pkwasniok/ki-smart-relay/hardware/hardware.kicad_pcb

## KiCad design hardware/hardware.kicad_pcb (2025-05-27)

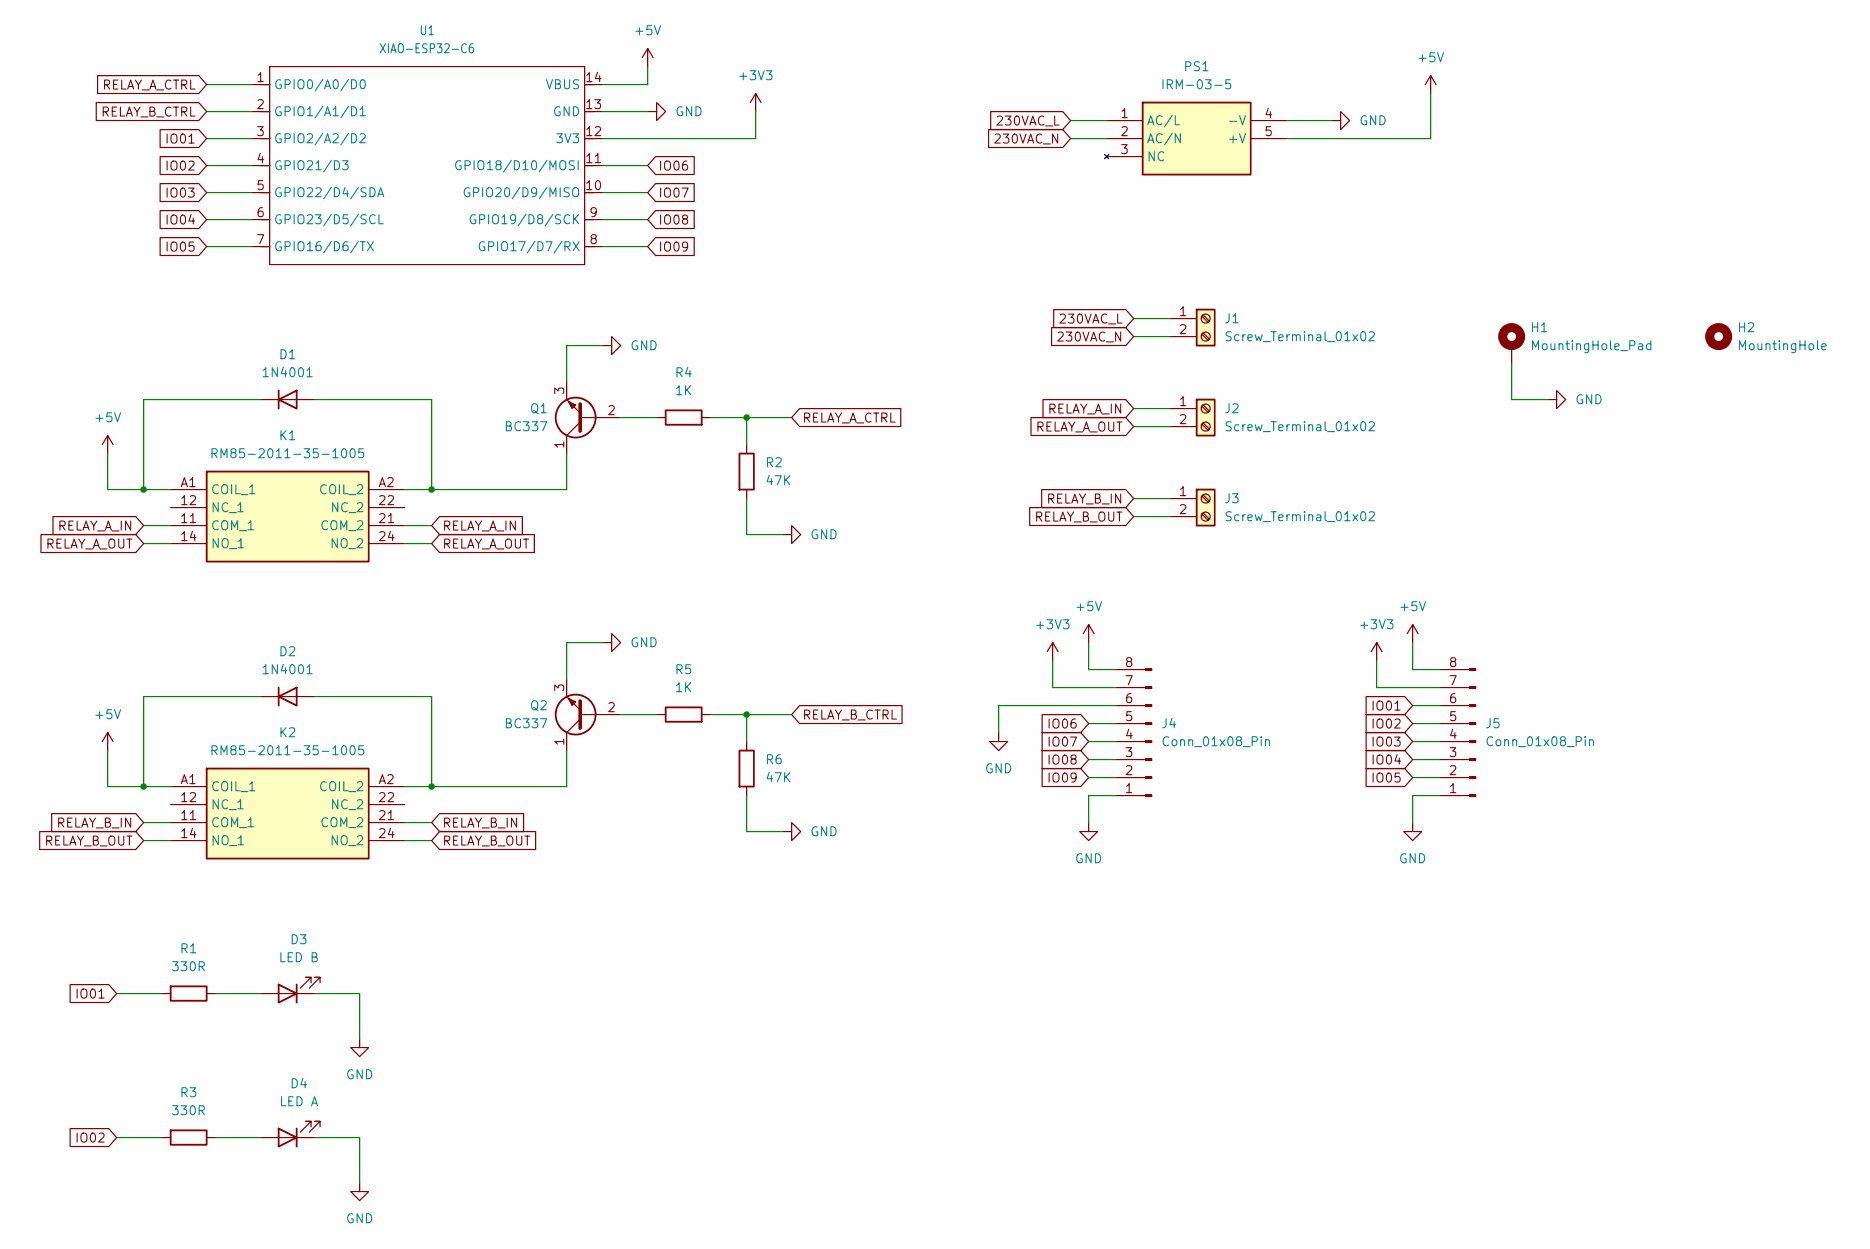
[picture p1: schematic hardware.kicad_sch]

Parts:
D1, D2: 1N4001; D_A-405_P7.62mm_Horizontal
D3: LED B; LED_D3.0mm
D4: LED A; LED_D3.0mm
H1: MountingHole_Pad; MountingHole_2.2mm_M2_Pad
H2: MountingHole; MountingHole_2.2mm_M2
J1, J2, J3: Screw_Terminal_01x02; SHDR2W100P0X500_1X2_1000X780X1020P
J4, J5: Conn_01x08_Pin; PinHeader_1x08_P2.54mm_Vertical
K1, K2: RM85-2011-35-1005; relpol_rm85_2011_35_1005; Manufacturer_Part_Number RM85-2011-35-1005
PS1: IRM-03-5; IRM0312; Manufacturer_Part_Number IRM-03-5
Q1, Q2: BC337; TO-92_Inline
R1, R3: 330R; R_Axial_DIN0204_L3.6mm_D1.6mm_P7.62mm_Horizontal
R2, R6: 47K; R_Axial_DIN0204_L3.6mm_D1.6mm_P7.62mm_Horizontal
R4, R5: 1K; R_Axial_DIN0204_L3.6mm_D1.6mm_P7.62mm_Horizontal
U1: XIAO-ESP32-C6; seeed_studio_xiao_esp32c6_dip

Connections:
230VAC_L: J1.1, PS1.1 (AC/L)
230VAC_N: J1.2, PS1.2 (AC/N)
+3V3: J4.7, J5.7, U1.12 (3V3)
+5V: D1.1 (K), D2.1 (K), J4.8, J5.8, K1.A1 (COIL_1), K2.A1 (COIL_1), PS1.5 (+V), U1.14 (VBUS)
GND: D3.1 (K), D4.1 (K), H1.1, J4.1, J4.6, J5.1, PS1.4 (-V), Q1.3 (E), Q2.3 (E), R2.2, R6.2, U1.13 (GND)
IO01: J5.6, R1.2, U1.3 (GPIO2/A2/D2)
IO02: J5.5, R3.2, U1.4 (GPIO21/D3)
IO03: J5.4, U1.5 (GPIO22/D4/SDA)
IO04: J5.3, U1.6 (GPIO23/D5/SCL)
IO05: J5.2, U1.7 (GPIO16/D6/TX)
IO06: J4.5, U1.11 (GPIO18/D10/MOSI)
IO07: J4.4, U1.10 (GPIO20/D9/MISO)
IO08: J4.3, U1.9 (GPIO19/D8/SCK)
IO09: J4.2, U1.8 (GPIO17/D7/RX)
unnamed: D1.2 (A), K1.A2 (COIL_2), Q1.1 (C)
unnamed: D2.2 (A), K2.A2 (COIL_2), Q2.1 (C)
unnamed: D3.2 (A), R1.1
unnamed: D4.2 (A), R3.1
unnamed: Q1.2 (B), R4.1
unnamed: Q2.2 (B), R5.1
RELAY_A_CTRL: R2.1, R4.2, U1.1 (GPIO0/A0/D0)
RELAY_A_IN: J2.1, K1.11 (COM_1), K1.21 (COM_2)
RELAY_A_OUT: J2.2, K1.14 (NO_1), K1.24 (NO_2)
RELAY_B_CTRL: R5.2, R6.1, U1.2 (GPIO1/A1/D1)
RELAY_B_IN: J3.1, K2.11 (COM_1), K2.21 (COM_2)
RELAY_B_OUT: J3.2, K2.14 (NO_1), K2.24 (NO_2)

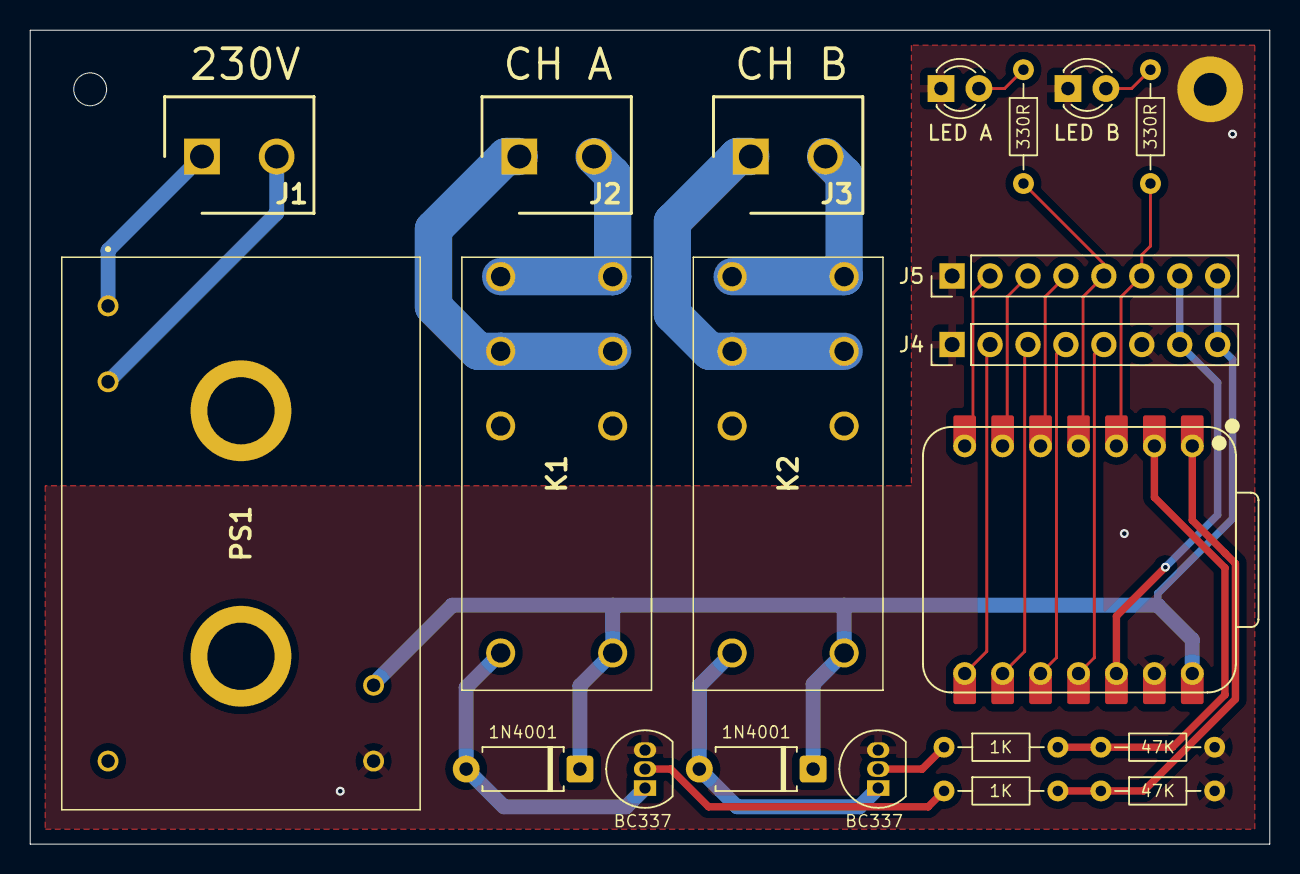
[picture p2: board hardware.kicad_pcb from above]

Board: 2 copper layers, 83.0 x 54.5 mm, 23 parts (0 on the bottom side), 26 nets.
