pkwasniok/ki-smart-relay/(commit log)

2025-05-11 ESP-IDF configuration for ESP32-C6
2025-05-11 Added KiCad libraries
    [hardware.kicad_sch]
2025-05-11 Started working on relay driving circuit
    [hardware.kicad_sch]
2025-05-12 Changed transitior orientation
    [hardware.kicad_sch]
2025-05-12 Added relay flyback diode
    [hardware.kicad_sch]
2025-05-12 Added pull-down resistor to relay control signal
    [hardware.kicad_sch]
2025-05-12 Added power supply
    [hardware.kicad_sch]
2025-05-12 Added second relay
    [hardware.kicad_sch]
2025-05-12 Added temperature sensor
    [hardware.kicad_sch]
2025-05-12 Added leds and connectors
    [hardware.kicad_pcb, hardware.kicad_sch]
2025-05-12 Started working on PCB
    [hardware.kicad_pcb, hardware.kicad_sch]
2025-05-12 Improved PCB layout
    [hardware.kicad_pcb]
2025-05-16 Started working on new PCB layout
    [hardware.kicad_pcb, hardware.kicad_sch]
2025-05-17 New layout with new screw terminals
    [hardware.kicad_pcb, hardware.kicad_sch]
2025-05-17 Removed DS18B20 temp sensor
    [hardware.kicad_pcb, hardware.kicad_sch]
2025-05-17 Started working on PCB traces
    [hardware.kicad_pcb, hardware.kicad_sch]
2025-05-23 Removed unnecessary resistors
    Removec resistors limiting current flowing through relay coils
    [hardware.kicad_sch]
2025-05-23 Updated PCB footprint layout
    Updatec PCB layout after removing resistors
    [hardware.kicad_pcb, hardware.kicad_sch]
2025-05-27 Added PCB traces
    [hardware.kicad_pcb]
2025-05-27 Added GND fill zone
    [hardware.kicad_pcb]
2025-05-27 Added mounting holes
    [hardware.kicad_pcb, hardware.kicad_sch]
2025-05-27 Updated screw terminals
    [hardware.kicad_pcb, hardware.kicad_sch]
2025-05-27 Finished PCB layout and traces
    [hardware.kicad_pcb, hardware.kicad_sch]
2025-05-27 Finished PCB silkscreen
    [hardware.kicad_pcb]
2025-05-27 Added headers for extra gpios
    [hardware.kicad_pcb, hardware.kicad_sch]
2025-05-27 Added status LEDs
    [hardware.kicad_pcb, hardware.kicad_sch]
2025-05-27 Removed solder mask from 230V HP traces
    [hardware.kicad_pcb]
2025-06-11 Device identifier generator
2025-06-11 Merged with old relay project
2025-06-14 Enable ceramic antenna during setup
2025-06-14 Changed from ceramic antenna to ufl antenna
2025-06-14 Wifi antenna switch driver
2025-08-05 publish relay status to mqtt topic
